laurynasziedas/epdiy/hardware/epaper-breakout/epaper-breakout.kicad_pcb

## KiCad design hardware/epaper-breakout/epaper-breakout.kicad_pcb (2020-10-13)

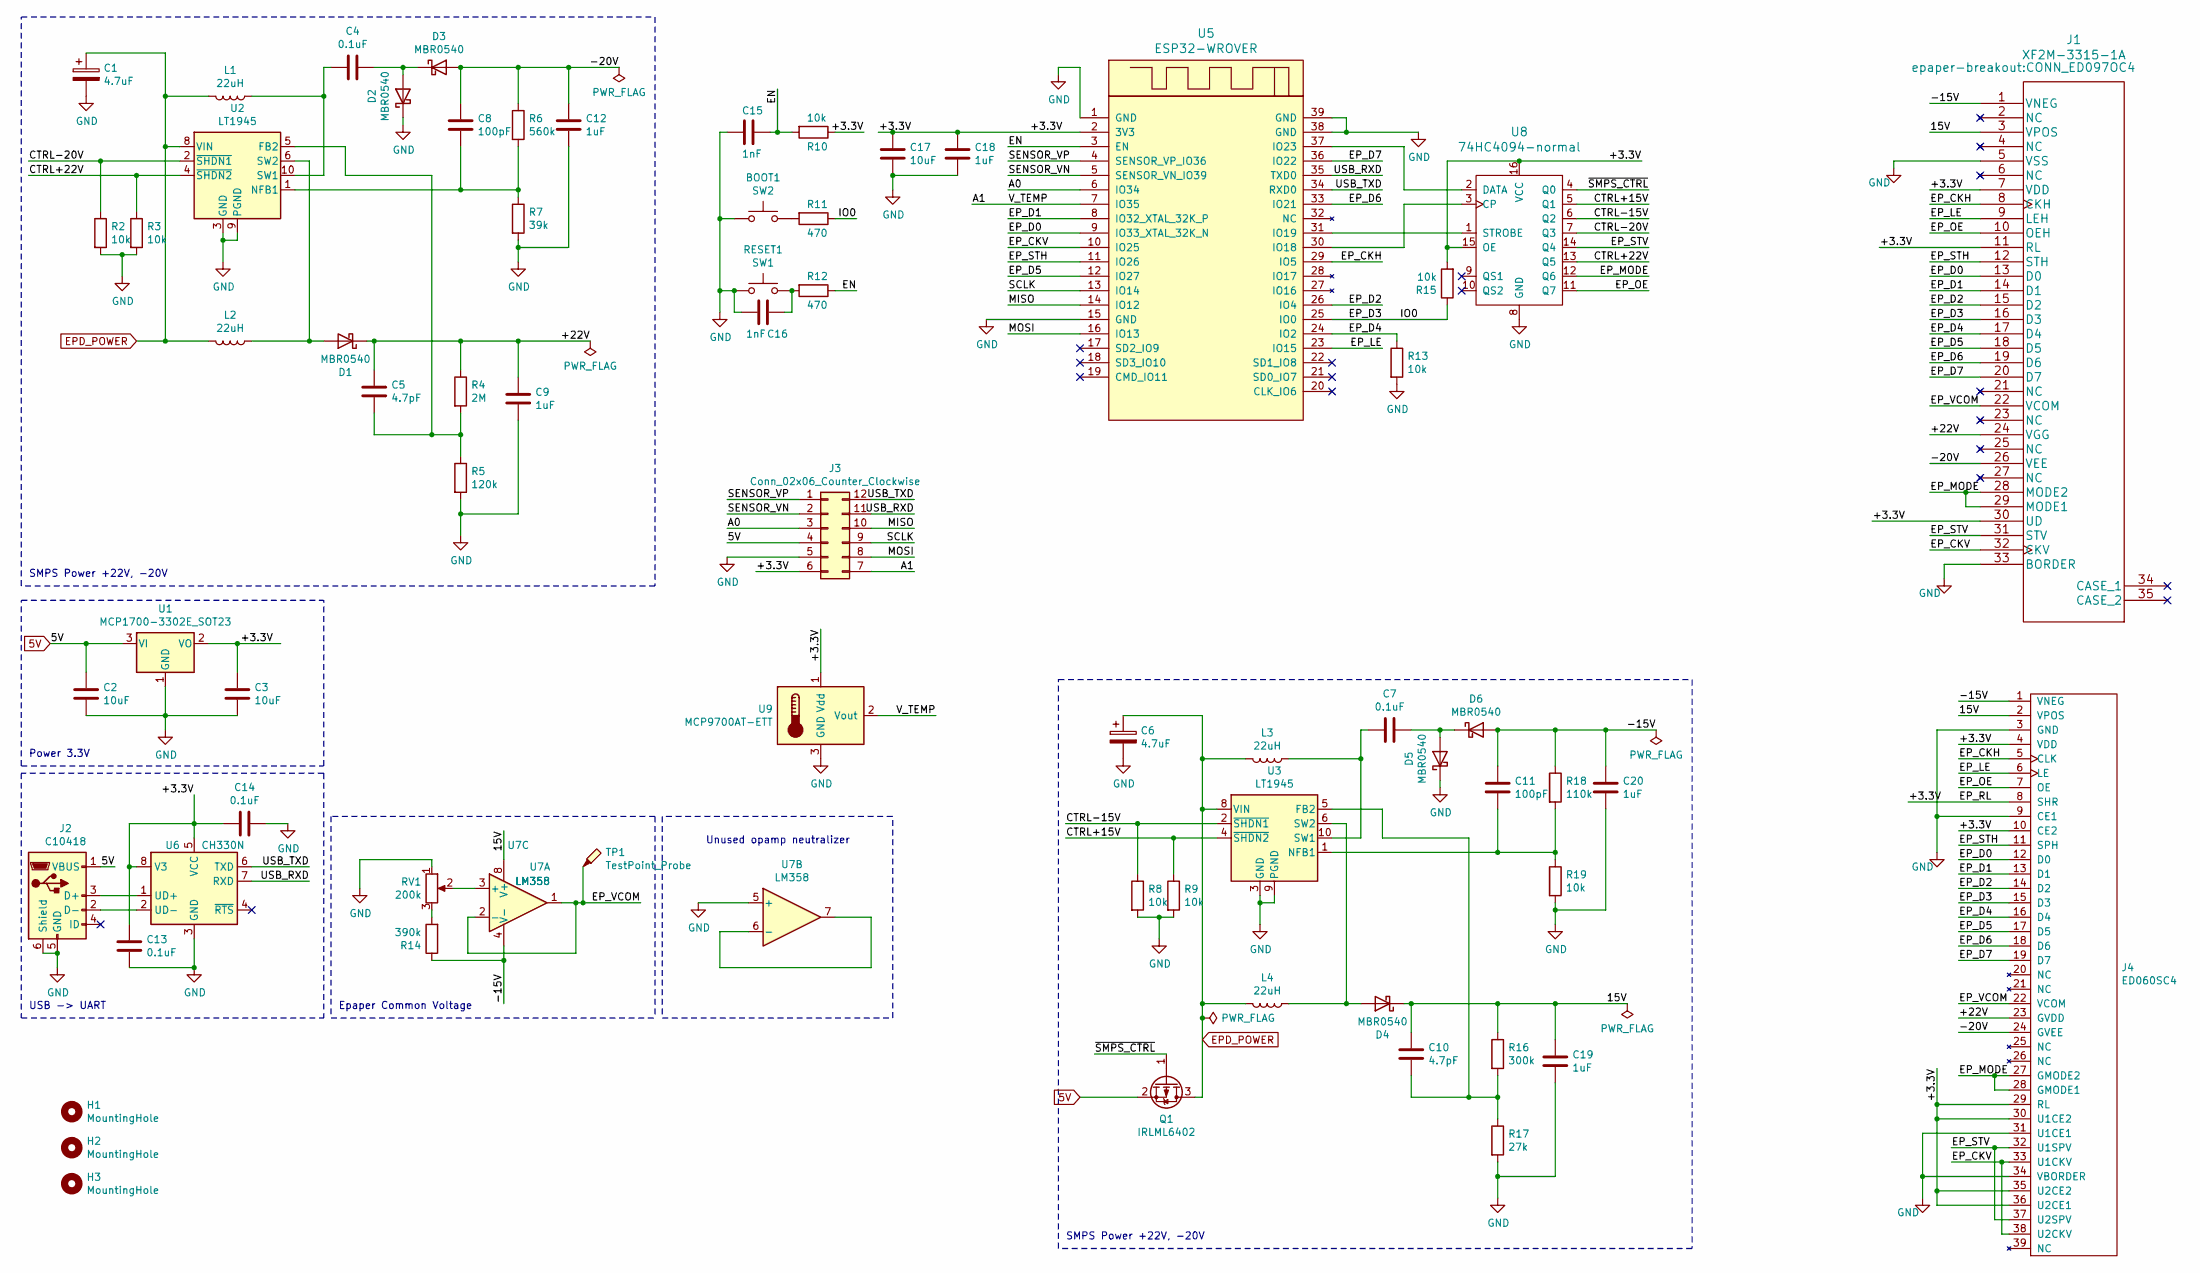
[picture p1: schematic epaper-breakout.sch, ED097OC4 Breakout]

Parts:
BOOT1: SW2; SW_TS-1187A
C1, C6: 4.7uF; C_0603_1608Metric
C2, C3, C17: 10uF; C_0603_1608Metric
C4, C7, C13, C14: 0.1uF; C_0603_1608Metric
C5, C10: 4.7pF; C_0603_1608Metric
C8, C11: 100pF; C_0603_1608Metric
C9, C12, C18, C19, C20: 1uF; C_0603_1608Metric
C15, C16: 1nF; C_0603_1608Metric
D1, D2, D3, D4, D5, D6: MBR0540; D_SOD-123
H1, H2, H3: MountingHole; MountingHole_2.2mm_M2
J1: XF2M-3315-1A; CONN_ED097OC4
J2: C10418; USB_Micro-B_A01SB141B1-067
J3: Conn_02x06_Counter_Clockwise; PinHeader_2x06_P2.54mm_Vertical
J4: ED060SC4; HRS_FH26W-39S-0.3SHW(60)
L1, L2, L3, L4: 22uH; L_6.3x6.3_H3
Q1: IRLML6402; SOT-23
R2, R3, R8, R9, R10, R13, R15, R19: 10k; R_0805_2012Metric
R4: 2M; R_0805_2012Metric
R5: 120k; R_0805_2012Metric
R6: 560k; R_0805_2012Metric
R7: 39k; R_0805_2012Metric
R11, R12: 470; R_0805_2012Metric
R14: 390k; R_0805_2012Metric
R16: 300k; R_0805_2012Metric
R17: 27k; R_0805_2012Metric
R18: 110k; R_0805_2012Metric
RESET1: SW1; SW_TS-1187A
RV1: 200k; EVM3ESX50B25
TP1: TestPoint_Probe; TestPoint_Pad_D1.0mm
U1: MCP1700-3302E_SOT23; SOT-23
U2, U3: LT1945; MSOP-10_3x3mm_P0.5mm
U5: ESP32-WROVER
U6: CH330N; SOIC-8_3.9x4.9mm_P1.27mm
U7: LM358; SOP-8_3.76x4.96mm_P1.27mm
U8: 74HC4094-normal; SOIC-16_3.9x9.9mm_P1.27mm
U9: MCP9700AT-ETT; SOT-23

Connections:
5V: C2.2, J2.1 (VBUS), J3.4, Q1.2 (S), U1.3 (VI)
/15V: C10.2, C19.2, D4.1 (K), J1.3 (VPOS), J4.2 (VPOS), R16.1, U7.8 (V+)
/+3.3V: C3.2, C13.1, C14.1, C17.1, C18.2, J1.7 (VDD), J1.11 (RL), J1.30 (UD), J3.6, J4.4 (VDD), J4.8 (SHR), J4.10 (CE2), J4.29 (RL), J4.30 (U1CE2), J4.35 (U2CE2), J4.36 (U2CE1), R10.1, R15.2, U1.2 (VO), U5.2 (3V3), U6.5 (VCC), U6.8 (V3), U8.15 (OE), U8.16 (VCC), U9.1 (Vdd)
/+22V: C5.2, C9.2, D1.1 (K), J1.24 (VGG), J4.23 (GVDD), R4.1
/-15V: C11.2, C20.2, D6.2 (A), J1.1 (VNEG), J4.1 (VNEG), R14.1, R18.1, U7.4 (V-)
/-20V: C8.2, C12.2, D3.2 (A), J1.26 (VEE), J4.24 (GVEE), R6.1
/A0: J3.3, U5.6 (IO34)
/A1: J3.7, U5.7 (IO35), U9.2 (Vout)
/CTRL+15V: R9.1, U3.4 (~SHDN2), U8.5 (Q1)
/CTRL+22V: R3.1, U2.4 (~SHDN2), U8.13 (Q5)
/CTRL-15V: R8.1, U3.2 (~SHDN1), U8.6 (Q2)
/CTRL-20V: R2.1, U2.2 (~SHDN1), U8.7 (Q3)
/EN: C15.2, R10.2, R12.1, U5.3 (EN)
/EP_CKH: J1.8 (CKH), J4.5 (CLK), U5.29 (IO5)
/EP_CKV: J1.32 (CKV), J4.33 (U1CKV), J4.38 (U2CKV), U5.10 (IO25)
/EP_D0: J1.13 (D0), J4.12 (D0), U5.9 (IO33_XTAL_32K_N)
/EP_D1: J1.14 (D1), J4.13 (D1), U5.8 (IO32_XTAL_32K_P)
/EP_D2: J1.15 (D2), J4.14 (D2), U5.26 (IO4)
/EP_D3: J1.16 (D3), J4.15 (D3), R11.1, R15.1, U5.25 (IO0)
/EP_D4: J1.17 (D4), J4.16 (D4), R13.1, U5.24 (IO2)
/EP_D5: J1.18 (D5), J4.17 (D5), U5.12 (IO27)
/EP_D6: J1.19 (D6), J4.18 (D6), U5.33 (IO21)
/EP_D7: J1.20 (D7), J4.19 (D7), U5.36 (IO22)
/EP_LE: J1.9 (LEH), J4.6 (LE), U5.23 (IO15)
/EP_MODE: J1.28 (MODE2), J1.29 (MODE1), J4.27 (GMODE2), J4.28 (GMODE1), U8.12 (Q6)
/EP_OE: J1.10 (OEH), J4.7 (OE), U8.11 (Q7)
/EP_STH: J1.12 (STH), J4.11 (SPH), U5.11 (IO26)
/EP_STV: J1.31 (STV), J4.32 (U1SPV), J4.37 (U2SPV), U8.14 (Q4)
/EP_VCOM: J1.22 (VCOM), J4.22 (VCOM), TP1.1, U7.1, U7.2 (-)
/MISO: J3.10, U5.14 (IO12)
/MOSI: J3.8, U5.16 (IO13)
/SCLK: J3.9, U5.13 (IO14)
/SENSOR_VN: J3.2, U5.5 (SENSOR_VN_IO39)
/SENSOR_VP: J3.1, U5.4 (SENSOR_VP_IO36)
/USB_RXD: J3.11, U5.35 (TXD0), U6.7 (RXD)
/USB_TXD: J3.12, U5.34 (RXD0), U6.6 (TXD)
/~SMPS_CTRL: Q1.1 (G), U8.4 (Q0)
EPD_POWER: C1.1, C6.1, L1.2, L2.2, L3.2, L4.2, Q1.3 (D), U2.8 (VIN), U3.8 (VIN)
GND: BOOT1.1, C1.2, C2.1, C3.1, C6.2, C9.1, C12.1, C13.2, C14.2, C15.1, C16.1, C17.2, C18.1, C19.1, C20.1, D2.1 (K), D5.1 (K), J1.5 (VSS), J1.33 (BORDER), J2.5 (GND), J2.6 (Shield), J3.5, J4.3 (GND), J4.9 (CE1), J4.31 (U1CE1), J4.34 (VBORDER), R2.2, R3.2, R5.2, R7.2, R8.2, R9.2, R13.2, R17.2, R19.2, RESET1.1, RV1.1, U1.1 (GND), U2.3 (GND), U2.7 (PGND), U2.9 (PGND), U3.3 (GND), U3.7 (PGND), U3.9 (PGND), U5.1 (GND), U5.15 (GND), U5.38 (GND), U5.39 (GND), U6.3 (GND), U7.5 (+), U8.8 (GND), U9.3 (GND)
unnamed: BOOT1.2, R11.2
unnamed: C4.1, D2.2 (A), D3.1 (K)
unnamed: C4.2, L1.1, U2.10 (SW1)
unnamed: C5.1, R4.2, R5.1, U2.5 (FB2)
unnamed: C7.1, D5.2 (A), D6.1 (K)
unnamed: C7.2, L3.1, U3.10 (SW1)
unnamed: C8.1, R6.2, R7.1, U2.1 (NFB1)
unnamed: C10.1, R16.2, R17.1, U3.5 (FB2)
unnamed: C11.1, R18.2, R19.1, U3.1 (NFB1)
unnamed: C16.2, R12.2, RESET1.2
unnamed: D1.2 (A), L2.1, U2.6 (SW2)
unnamed: D4.2 (A), L4.1, U3.6 (SW2)
unnamed: J2.2 (D-), U6.2 (UD-)
unnamed: J2.3 (D+), U6.1 (UD+)
unnamed: R14.2, RV1.3
unnamed: RV1.2, U7.3 (+)
unnamed: U5.30 (IO18), U8.3 (CP)
unnamed: U5.31 (IO19), U8.1 (STROBE)
unnamed: U5.37 (IO23), U8.2 (DATA)
unnamed: U7.6 (-), U7.7

Notes on the sheet:
SMPS Power +22V, -20V
Power 3.3V
USB -> UART
Epaper Common Voltage
Unused opamp neutralizer

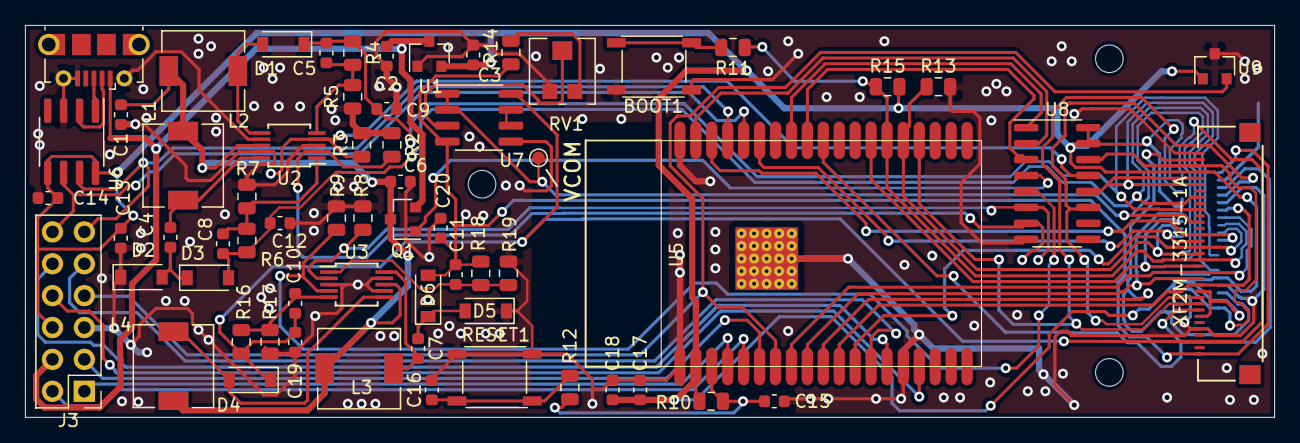
[picture p2: board epaper-breakout.kicad_pcb from above]

Board: 2 copper layers, 99.6 x 31.2 mm, 68 parts (1 on the bottom side), 59 nets.
